srluo/NFC_ACCP/SCH-2021-1015-1.png

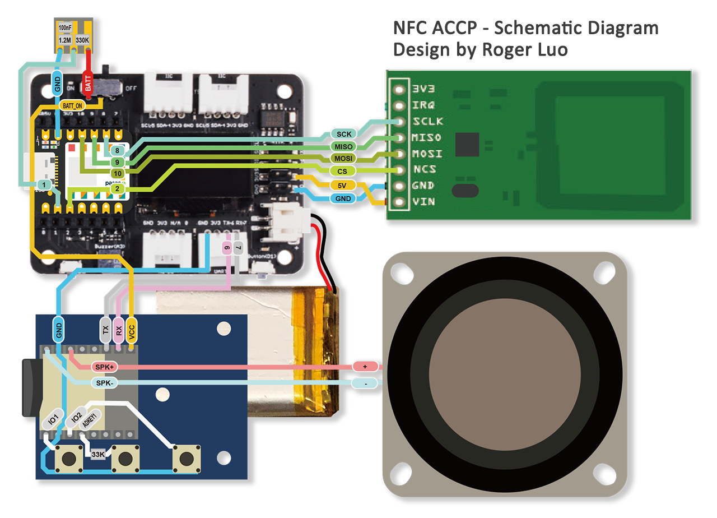
SCH-2021-1015-1.png
