srluo/NFC_ACCP/Templete/X-DISC封面-54mm.pdf

## 貼上雙面膠

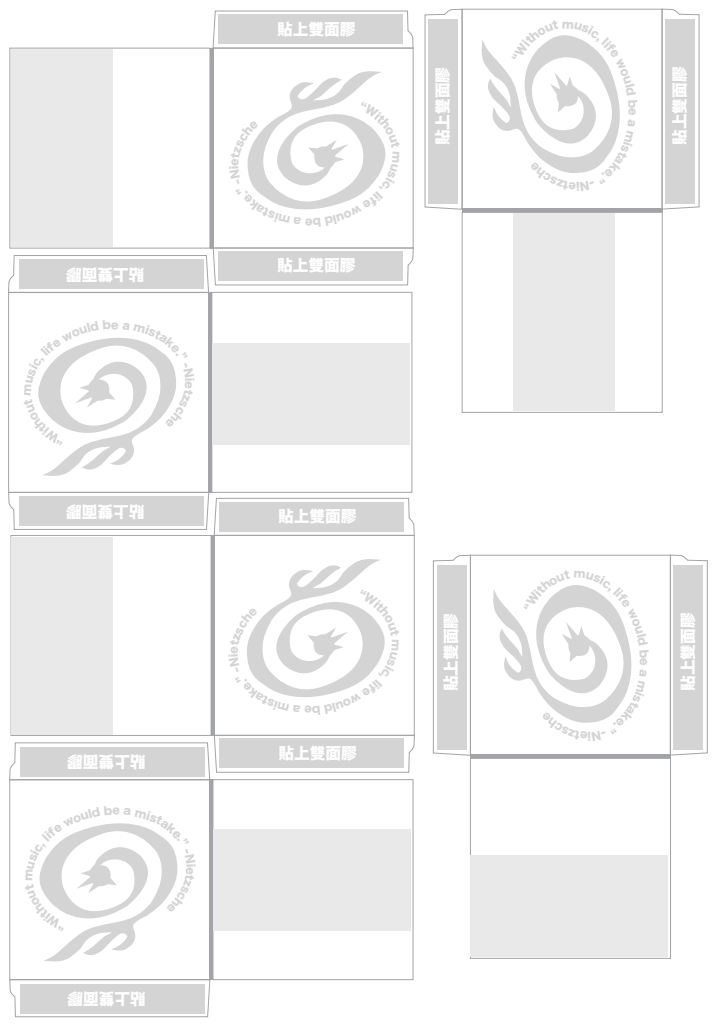
[picture p2: page 1]
貼上雙面膠; “Without; b e a m si take

“Without music, life would

usic, life would be a mistake.” -Nietzsche
